catarinaplamadeala/Voltage-Regulator/Layout/LAYOUT.png

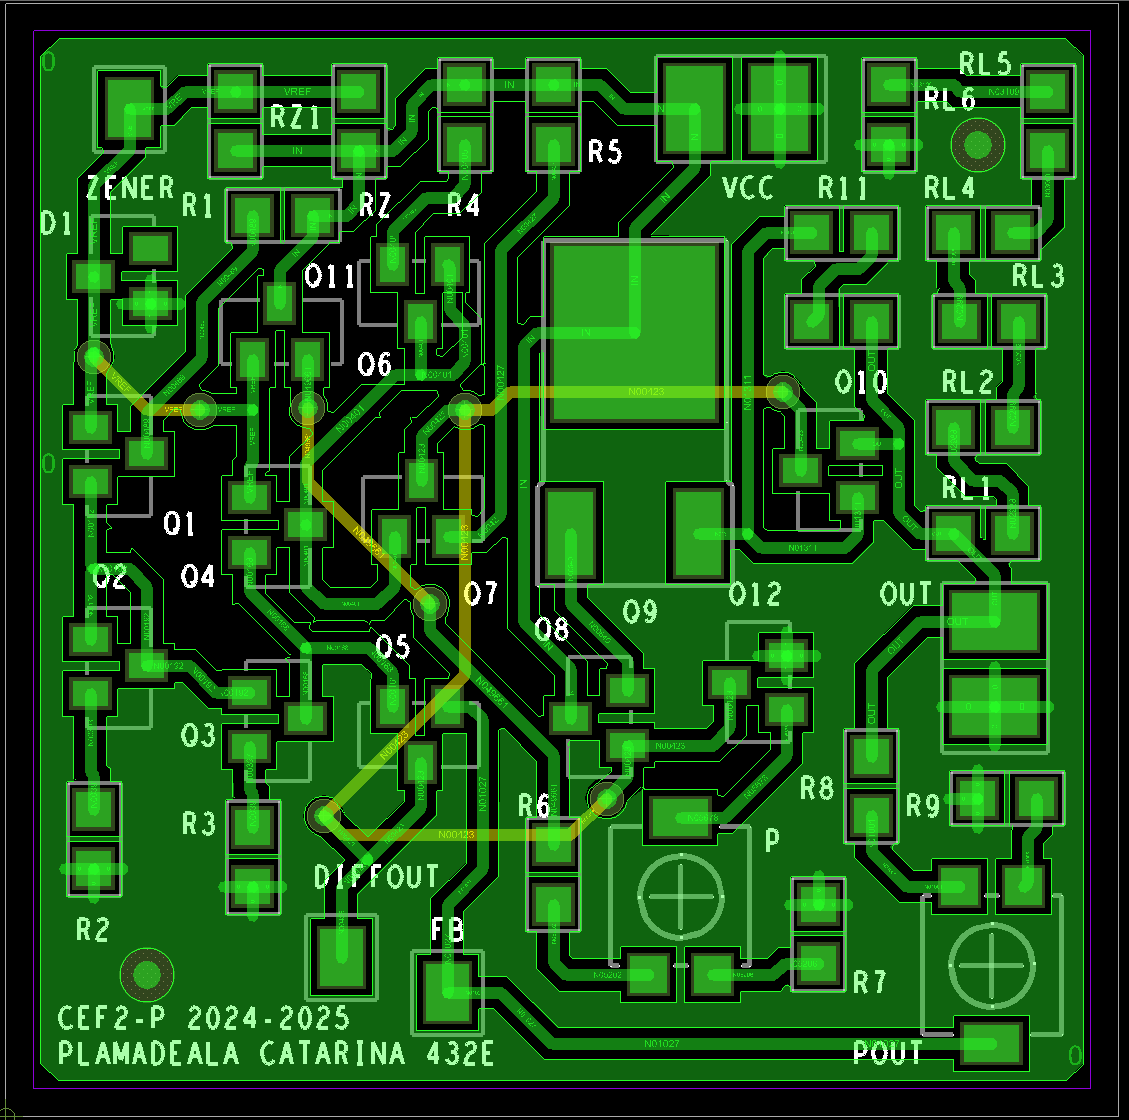
Layout/LAYOUT.png
