catarinaplamadeala/Voltage-Regulator/schema_bloc.png

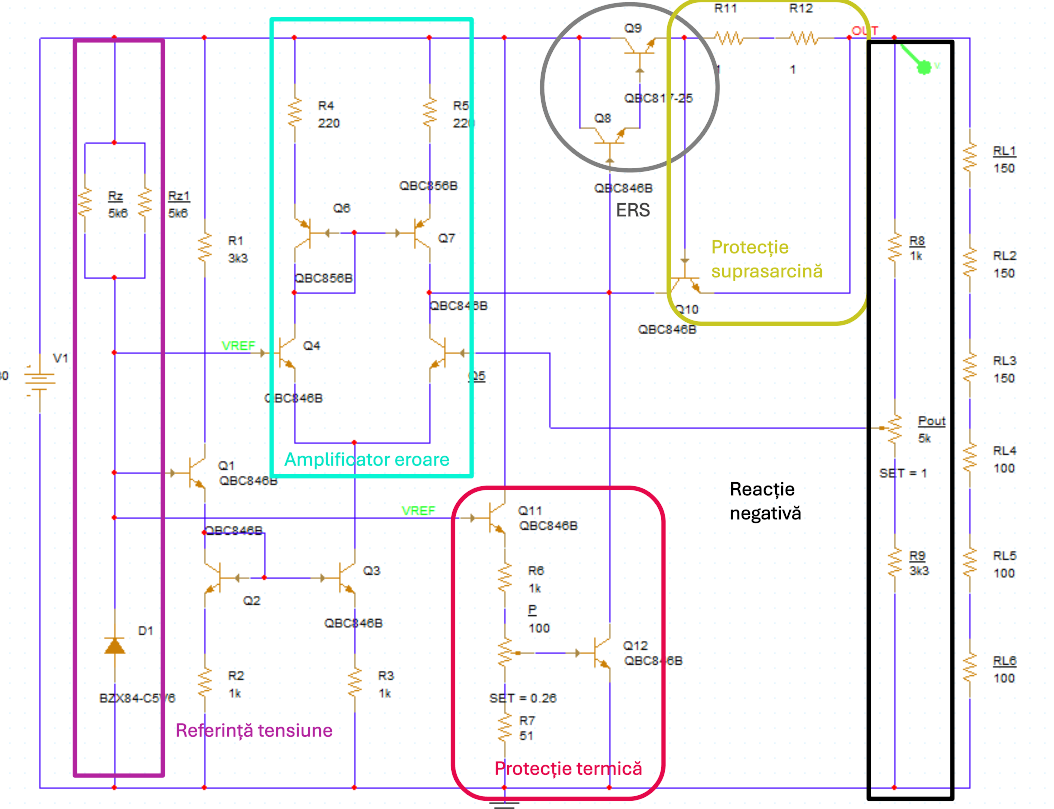
schema_bloc.png
