catarinaplamadeala/Voltage-Regulator/Schematics/P1_STAB_TENS.png

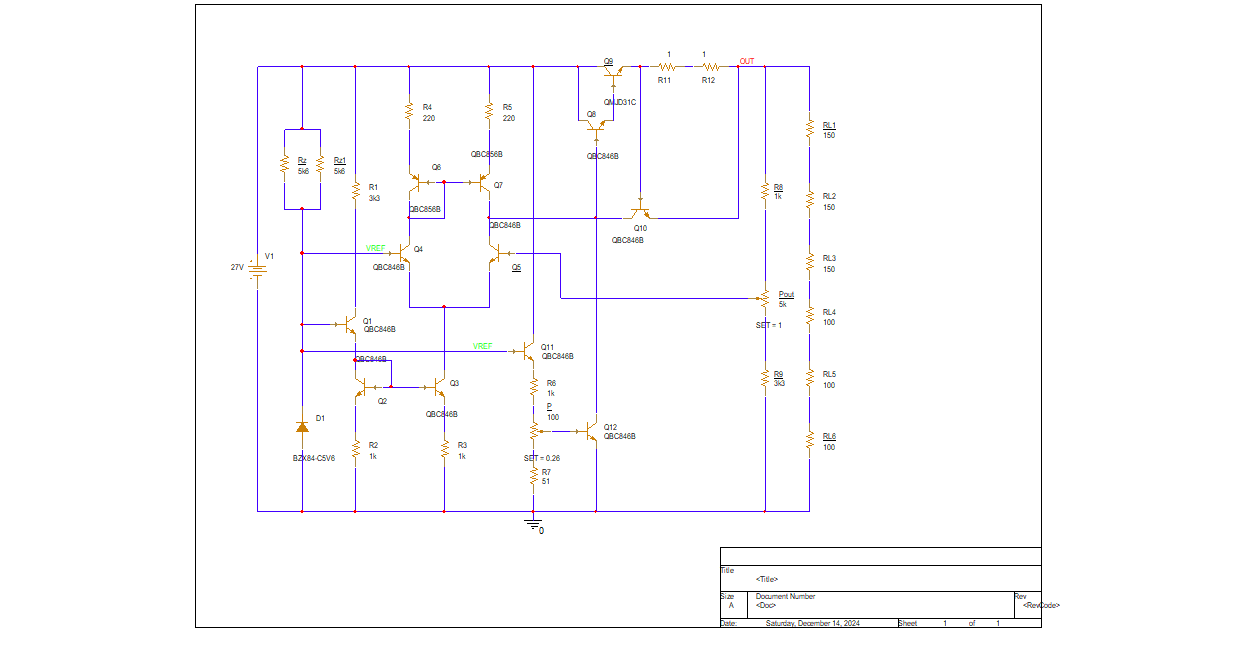
Schematics/P1_STAB_TENS.png
