catarinaplamadeala/Voltage-Regulator/(list of files, drawings)

Other design files:
Schematics/p1_stab_tens/P1_STAB_TENS.DSN
Schematics/p1_stab_tens/p1_stab_tens.opj
